Tetramad/magnetometer/Docs/schematic-magnetometer-v1.4.pdf

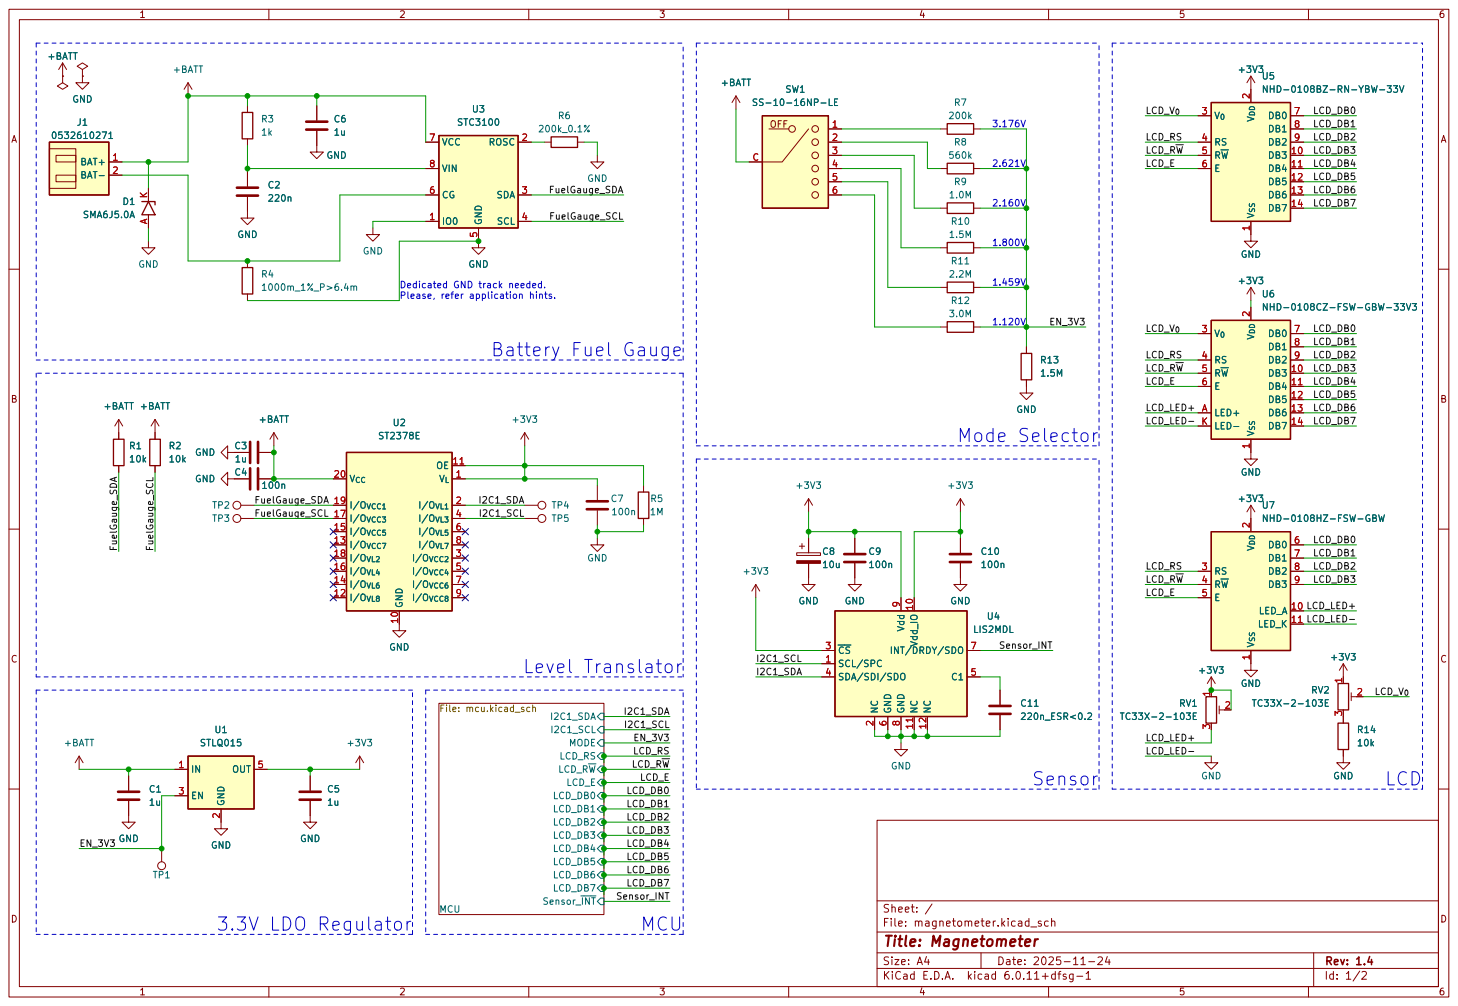
[picture p8: page 1]

3 U5 NHD-0108BZ-RN-YBW-33V V_{SS} 1 DB3

3 GND
+3V3 GND
U7 NHD-0108HZ-FSW-GBW V_{SS} 1

2 ~{CS} 3 SDA/SDI/SDO 4 C1 5 GND

6 INT/DRDY/SDO 7 GND

Id: 1/2 Title: Magnetometer File: magnetometer.kicad_sch Sheet: /

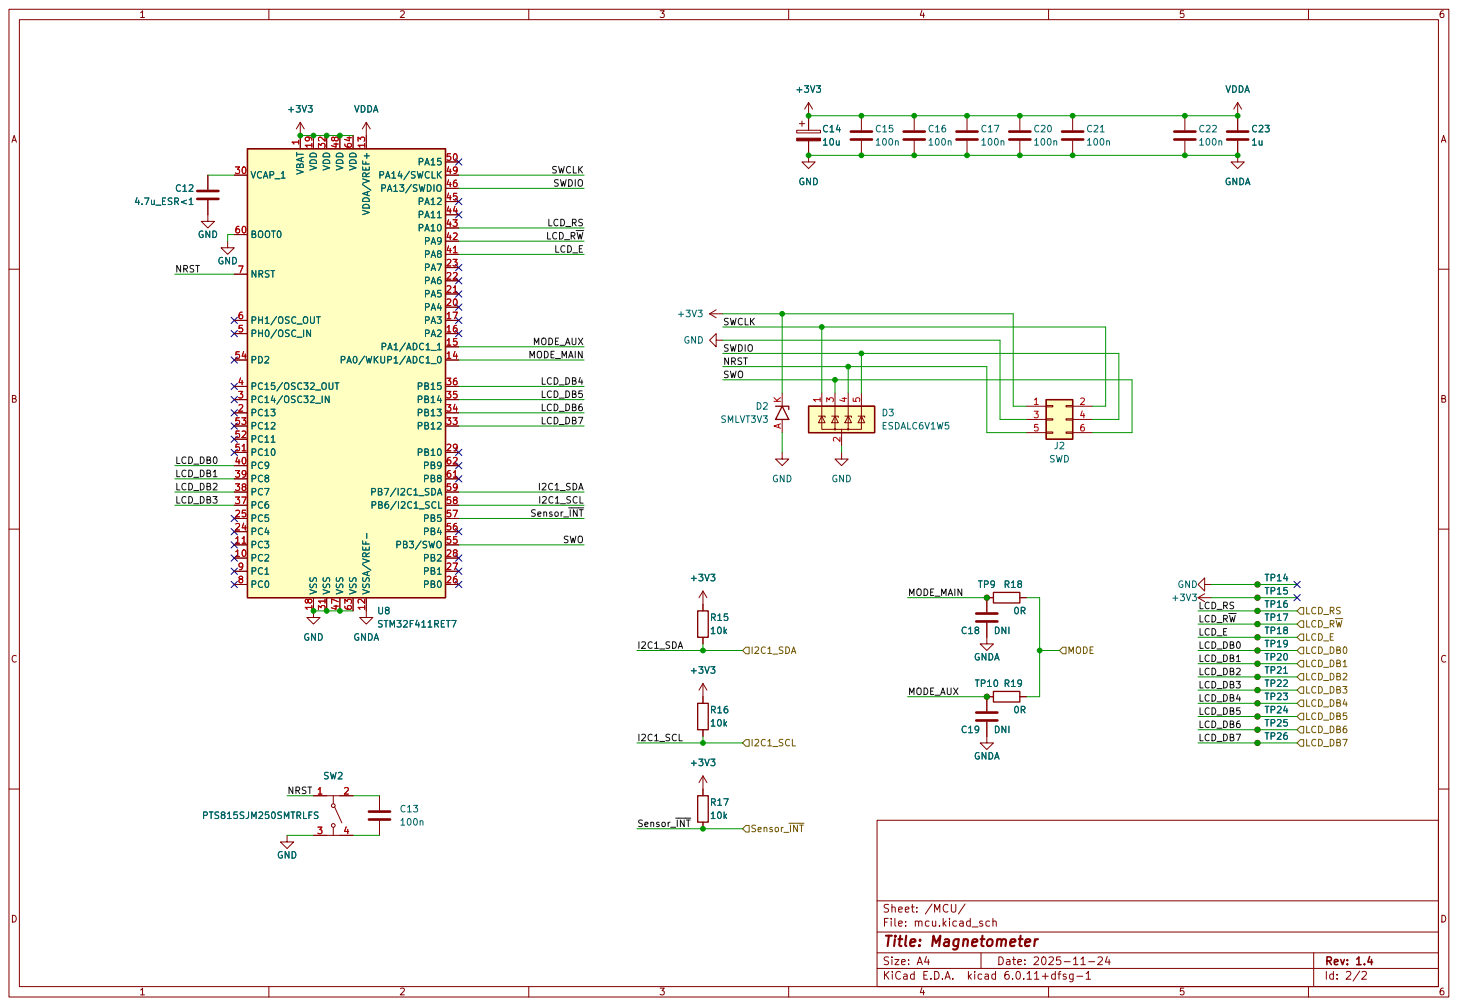
[picture p9: page 2]
