Tetramad/magnetometer/Docs/schematic-magnetometer-v1.1.pdf

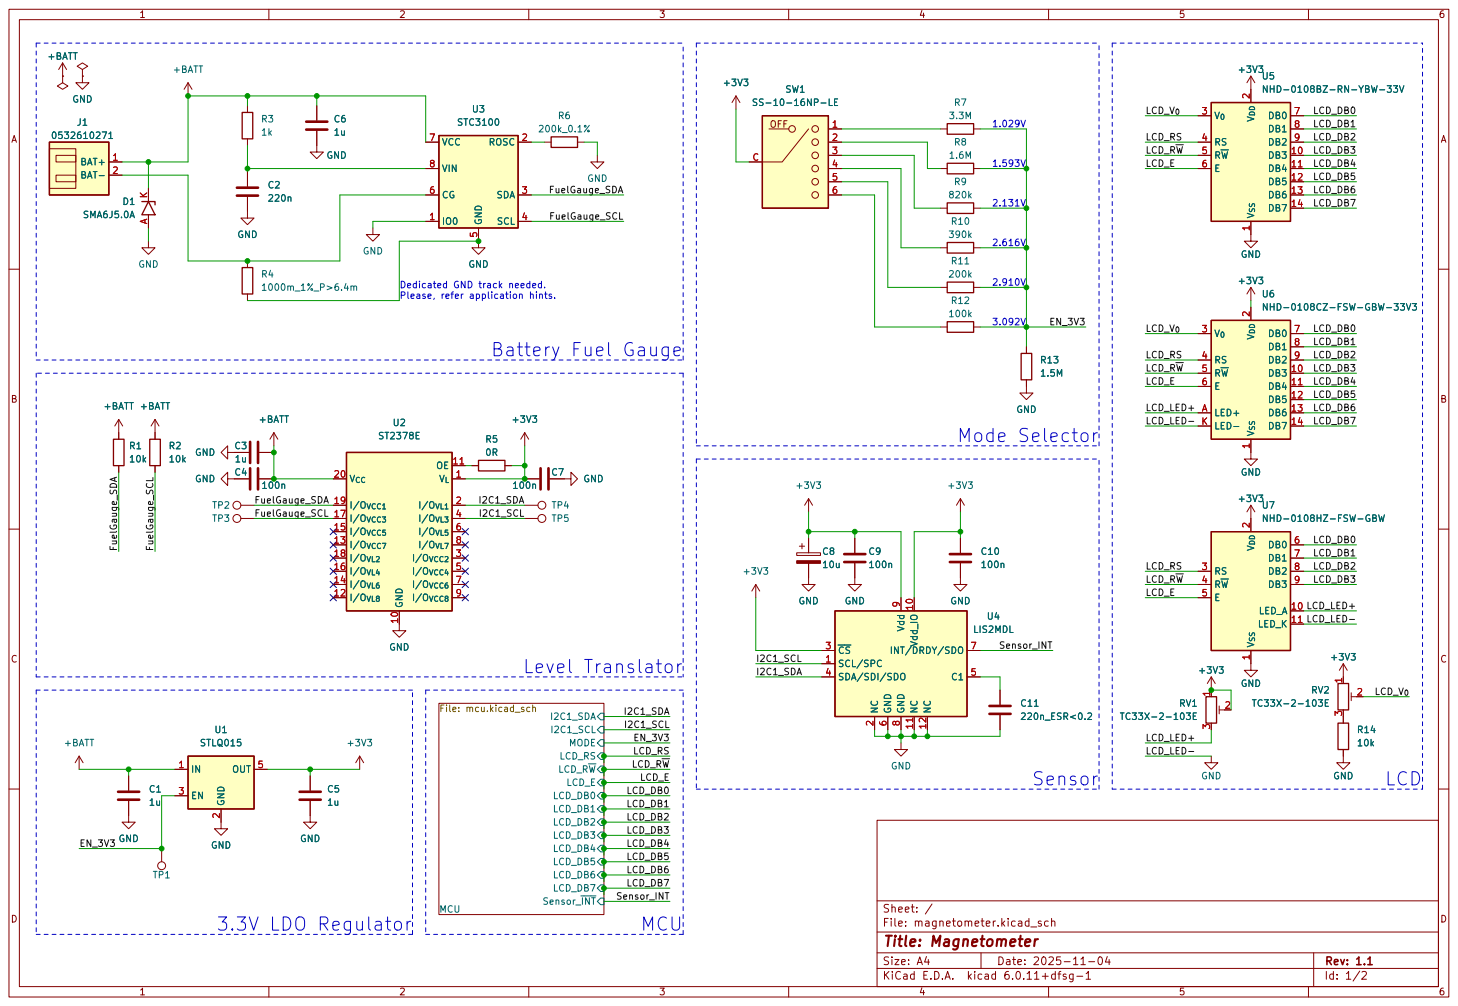
[picture p10: page 1]

U7 NHD-0108HZ-FSW-GBW V_{SS} 1

2 ~{CS} 3 SDA/SDI/SDO 4 C1 5 GND

6 INT/DRDY/SDO 7 GND

Id: 1/2 Title: Magnetometer File: magnetometer.kicad_sch Sheet: /

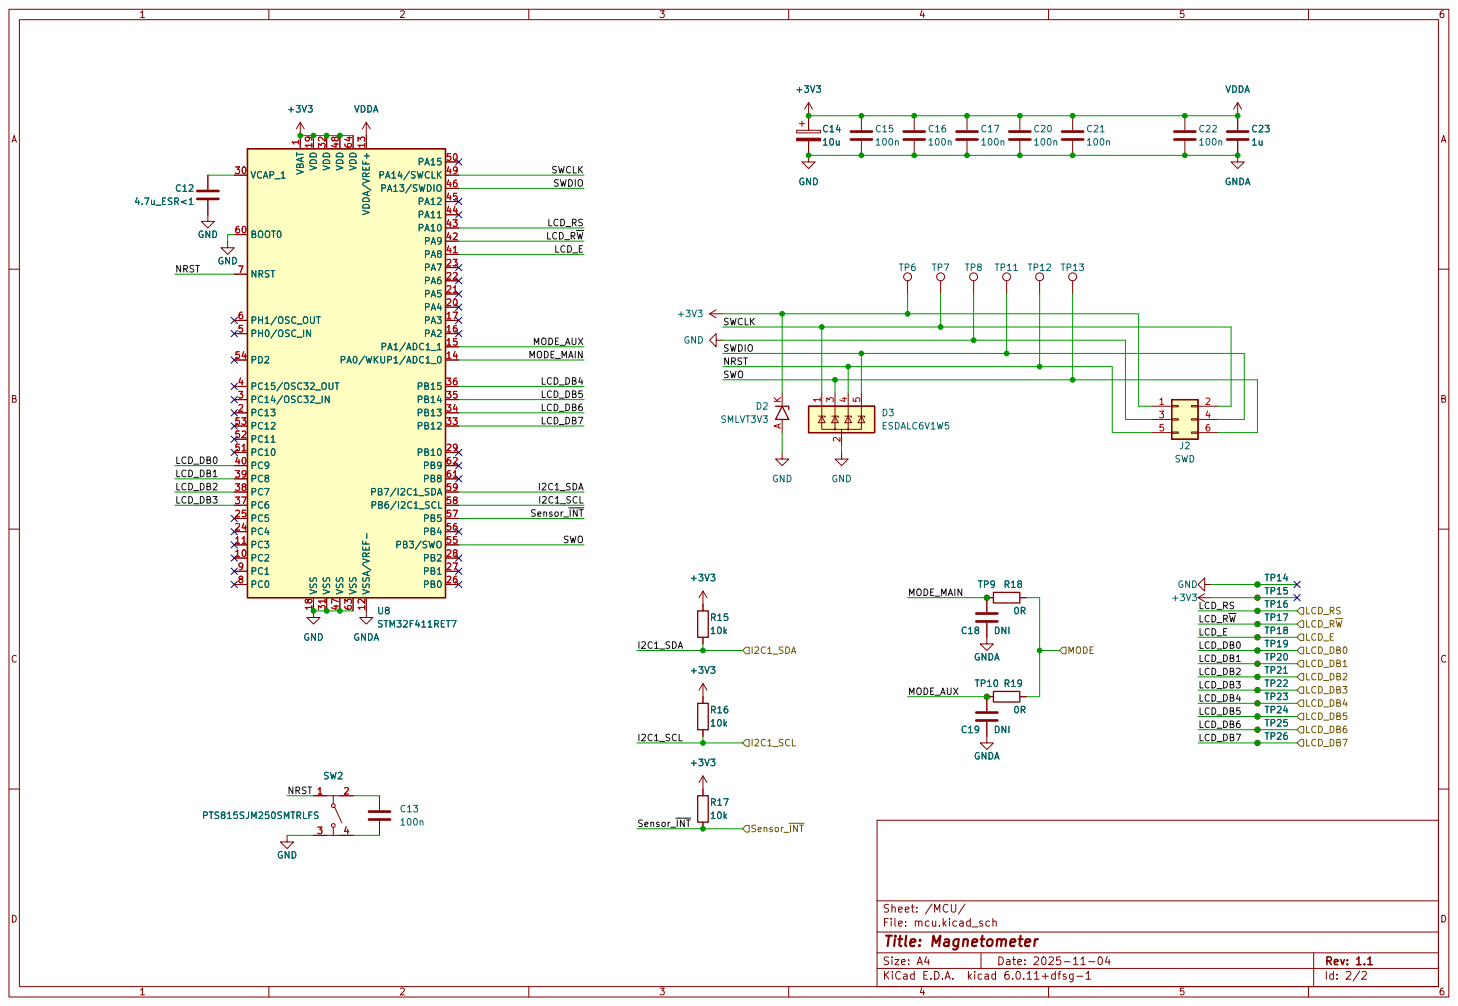
[picture p11: page 2]

Id: 2/2 Title: Magnetometer File: mcu.kicad_sch Sheet: /MCU/
