Tetramad/magnetometer/Core/Src/main.c

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
/* Includes ------------------------------------------------------------------*/
#include "main.h"

/* USER CODE BEGIN Includes */
#include <assert.h>
#include <math.h>
#include <stddef.h>
#include <stdint.h>
#include <stdlib.h>

#include <log.h>

/* USER CODE END Includes */

/* USER CODE BEGIN PTD */
struct tick_aligned_task {
    uint64_t target_tick;
    const uint16_t tick_alignment; /*< 32767 (~32s) Max. */
    HAL_StatusTypeDef (*const task)(void);
    const char *const name;
};

/* USER CODE END PTD */

/* USER CODE BEGIN PD */
#define MAGNETIC_FLUX_OFFSET_X ((int16_t)(151.319))
#define MAGNETIC_FLUX_OFFSET_Y ((int16_t)(304.571))
#define MAGNETIC_FLUX_OFFSET_Z ((int16_t)(-471.442))
/* USER CODE END PD */

ADC_HandleTypeDef hadc1;

I2C_HandleTypeDef hi2c1;

RTC_HandleTypeDef hrtc;

TIM_HandleTypeDef htim2;

/* USER CODE BEGIN PV */
LOG_LEVEL_SET(LOG_LEVEL_INF);

MOD_HandleTypeDef hmod;
LIS2MDL_HandleTypeDef hlis2mdl;
STC3100_HandleTypeDef hstc3100;
UDELAY_HandleTypeDef hmicrowait;
ST7066U_HandleTypeDef hdisplay;

MOD_ModeStateTypedef mode_state = MOD_MODE_STATE_UNKNOWN;

float magnetic_flux_x_mgauss = 0.0f;
float magnetic_flux_y_mgauss = 0.0f;
float magnetic_flux_z_mgauss = 0.0f;
float magnetic_flux_magnitude_mgauss = 0.0f;
float magnetic_flux_bearing_degree = 0.0f;

float gas_gauge_charge_used_uah = 0.0f;
float gas_gauge_voltage_mv = 0.0f;
/* USER CODE END PV */

void SystemClock_Config(void);
static void MX_GPIO_Init(void);
static void MX_ADC1_Init(void);
static void MX_I2C1_Init(void);
static void MX_RTC_Init(void);
static void MX_TIM2_Init(void);
/* USER CODE BEGIN PFP */
static void NotMX_MOD_Init(void);
static void NotMX_LIS2MDL_Init(void);
static void NotMX_STC3100_Init(void);
static void NotMX_UDELAY_Init(void);
static void NotMX_DISPLAY_Init(void);
static HAL_StatusTypeDef Task_ModeUpdate(void);
static HAL_StatusTypeDef Task_MagneticMeasurementUpdate(void);
static HAL_StatusTypeDef Task_SOHUpdate(void);
static HAL_StatusTypeDef Task_DisplayUpdate(void);
/* USER CODE END PFP */

/**
  * @brief  The application entry point.
  * @retval int
  */
int main(void) {

    /* USER CODE BEGIN 1 */
    HAL_StatusTypeDef status = HAL_OK;
    uint64_t latest_extend_tick = 0U;
    /* USER CODE END 1 */

    /* MCU Configuration--------------------------------------------------------*/

    /* Reset of all peripherals, Initializes the Flash interface and the Systick. */
    HAL_Init();

    /* Configure the system clock */
    SystemClock_Config();

    /* USER CODE BEGIN SysInit */
    HAL_Delay(50);
    /* USER CODE END SysInit */

    /* Initialize all configured peripherals */
    MX_GPIO_Init();
    MX_ADC1_Init();
    MX_I2C1_Init();
    MX_RTC_Init();
    MX_TIM2_Init();
    /* USER CODE BEGIN 2 */
    HAL_Delay(50);

    NotMX_MOD_Init();
    NotMX_LIS2MDL_Init();
    NotMX_STC3100_Init();
    NotMX_UDELAY_Init();
    NotMX_DISPLAY_Init();

    HAL_Delay(50);

    LOG_INF("Magnetometer");
    LOG_INF("H/W Rev.2");
    LOG_INF("F/W Ver.1.3.0");

    HAL_Delay(50);

    struct tick_aligned_task tasks[] = {
        [0] = {.target_tick = 0,
               .tick_alignment = 1000,
               .task = Task_ModeUpdate,
               .name = "ModeUpdate"},
        [1] = {.target_tick = 0,
               .tick_alignment = 200,
               .task = Task_MagneticMeasurementUpdate,
               .name = "MagneticMeasurementUpdate"},
        [2] = {.target_tick = 0,
               .tick_alignment = 1000,
               .task = Task_SOHUpdate,
               .name = "SOHUpdate"},
        [3] = {.target_tick = 0,
               .tick_alignment = 200,
               .task = Task_DisplayUpdate,
               .name = "DisplayUpdate"},
    };
    /* USER CODE END 2 */

    /* Infinite loop */
    /* USER CODE BEGIN WHILE */
    assert(sizeof(tasks) / sizeof(*tasks) > 0);
    for (struct tick_aligned_task *t = &tasks[0];
         t < &tasks[sizeof(tasks) / sizeof(*tasks)];
         ++t) {
        assert(t->target_tick <= UINT32_MAX &&
               t->tick_alignment <= UINT16_MAX / 2);
    }
    while (1) {
        const uint32_t current_tick = HAL_GetTick();
        if ((latest_extend_tick & 0xFFFFFFFFULL) > current_tick) {
            latest_extend_tick += 0x100000000ULL;
        }
        latest_extend_tick &= ~0xFFFFFFFFULL;
        latest_extend_tick += current_tick;

        struct tick_aligned_task *task = NULL;
        for (struct tick_aligned_task *t = &tasks[0];
             t < &tasks[sizeof(tasks) / sizeof(*tasks)];
             ++t) {
            if (t->target_tick <= latest_extend_tick) {
                task = t;
                break;
            }
        }

        if (task != NULL) {
            task->target_tick = latest_extend_tick -
                                (latest_extend_tick % task->tick_alignment) +
                                task->tick_alignment;
            if (task->task != NULL) {
                status = task->task();
                if (status != HAL_OK) {
                    LOG_ERR("task(%s) failed", task->name);
                    task->target_tick = UINT32_MAX;
                }
            }
            continue;
        }

        task = &tasks[0];
        for (struct tick_aligned_task *t = &tasks[0];
             t < &tasks[sizeof(tasks) / sizeof(*tasks)];
             ++t) {
            if (task->target_tick > t->target_tick) {
                task = t;
            }
        }

        assert(task->target_tick - latest_extend_tick <= UINT16_MAX / 2);
        const uint32_t stop_duration =
            (uint16_t)((task->target_tick - latest_extend_tick) * 2);
        HAL_SuspendTick();
        HAL_RTCEx_SetWakeUpTimer_IT(
            &hrtc, stop_duration, RTC_WAKEUPCLOCK_RTCCLK_DIV16);
        HAL_PWR_EnterSTOPMode(PWR_LOWPOWERREGULATOR_ON, PWR_STOPENTRY_WFI);
        HAL_RTCEx_DeactivateWakeUpTimer(&hrtc);
        /* Add elapsed tick while STOP */
        uwTick += (uint32_t)(task->target_tick - latest_extend_tick);
        HAL_ResumeTick();
        /* USER CODE END WHILE */

        /* USER CODE BEGIN 3 */
    }
    /* USER CODE END 3 */
}

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
/* USER CODE BEGIN 4 */
static void NotMX_MOD_Init(void) {
    hmod.ADCInstance = &hadc1;

    if (MOD_Init(&hmod) != HAL_OK) {
        Error_Handler();
    }
}

static void NotMX_LIS2MDL_Init(void) {
    hlis2mdl.I2CInstance = &hi2c1;

    if (LIS2MDL_Init(&hlis2mdl) != HAL_OK) {
        LOG_ERR("failed to initialize LIS2MDL");
        Error_Handler();
    }
}

static void NotMX_STC3100_Init(void) {
    hstc3100.I2CInstance = &hi2c1;

    if (STC3100_Init(&hstc3100) != HAL_OK) {
        LOG_ERR("failed to initialize STC3100");
        Error_Handler();
    }
}

static void NotMX_UDELAY_Init(void) {
    hmicrowait.TIMInstance = &htim2;

    if (UDELAY_Init(&hmicrowait) != HAL_OK) {
        LOG_ERR("failed to initialize MICROWAIT");
        Error_Handler();
    }
}

static void NotMX_DISPLAY_Init(void) {
    hdisplay.MICROWAITInstance = &hmicrowait;
    hdisplay.Init.BusMode = ST7066U_BUS_MODE_4;

    hdisplay.Init.RS_Port = LCD_RS_GPIO_Port;
    hdisplay.Init.RS_Pin = LCD_RS_Pin;
    hdisplay.Init.RW_Port = LCD_RW_GPIO_Port;
    hdisplay.Init.RW_Pin = LCD_RW_Pin;
    hdisplay.Init.E_Port = LCD_E_GPIO_Port;
    hdisplay.Init.E_Pin = LCD_E_Pin;

    hdisplay.Init.DB_Port[0] = LCD_DB0_GPIO_Port;
    hdisplay.Init.DB_Pin[0] = LCD_DB0_Pin;
    hdisplay.Init.DB_Port[1] = LCD_DB1_GPIO_Port;
    hdisplay.Init.DB_Pin[1] = LCD_DB1_Pin;
    hdisplay.Init.DB_Port[2] = LCD_DB2_GPIO_Port;
    hdisplay.Init.DB_Pin[2] = LCD_DB2_Pin;
    hdisplay.Init.DB_Port[3] = LCD_DB3_GPIO_Port;
    hdisplay.Init.DB_Pin[3] = LCD_DB3_Pin;
    hdisplay.Init.DB_Port[4] = LCD_DB4_GPIO_Port;
    hdisplay.Init.DB_Pin[4] = LCD_DB4_Pin;
    hdisplay.Init.DB_Port[5] = LCD_DB5_GPIO_Port;
    hdisplay.Init.DB_Pin[5] = LCD_DB5_Pin;
    hdisplay.Init.DB_Port[6] = LCD_DB6_GPIO_Port;
    hdisplay.Init.DB_Pin[6] = LCD_DB6_Pin;
    hdisplay.Init.DB_Port[7] = LCD_DB7_GPIO_Port;
    hdisplay.Init.DB_Pin[7] = LCD_DB7_Pin;

    if (ST7066U_Init(&hdisplay) != HAL_OK) {
        LOG_ERR("failed to initialize DISPLAY");
        Error_Handler();
    }
}

HAL_StatusTypeDef Task_ModeUpdate(void) {
    HAL_StatusTypeDef status = HAL_OK;

    status = MOD_UpdateMode(&hmod);
    if (status != HAL_OK) {
        LOG_ERR("failed to update mode");
        return HAL_ERROR;
    }

    mode_state = MOD_ReadMode(&hmod);

    switch (mode_state) {
    default:
    case MOD_MODE_STATE_UNKNOWN:
        LOG_DBG("Mode [Unknown]");
        return HAL_OK;
    case MOD_MODE_STATE_X:
        LOG_DBG("Mode [X]");
        return HAL_OK;
    case MOD_MODE_STATE_Y:
        LOG_DBG("Mode [Y]");
        return HAL_OK;
    case MOD_MODE_STATE_Z:
        LOG_DBG("Mode [Z]");
        return HAL_OK;
    case MOD_MODE_STATE_MAGNITUDE:
        LOG_DBG("Mode [Magnitude]");
        return HAL_OK;
    case MOD_MODE_STATE_BEARING:
        LOG_DBG("Mode [Bearing]");
        return HAL_OK;
    case MOD_MODE_STATE_SOH:
        LOG_DBG("Mode [SOH]");
        return HAL_OK;
    }
}

HAL_StatusTypeDef Task_MagneticMeasurementUpdate(void) {
    HAL_StatusTypeDef status = HAL_OK;

    status = LIS2MDL_CheckSanity(&hlis2mdl);
    if (status != HAL_OK) {
        return HAL_ERROR;
    }

    status = LIS2MDL_StartSingleMode(&hlis2mdl);
    if (status != HAL_OK) {
        return HAL_ERROR;
    }

    uint16_t x_code = 0U;
    uint16_t y_code = 0U;
    uint16_t z_code = 0U;

    status = LIS2MDL_OUTXYZ(&hlis2mdl, &x_code, &y_code, &z_code);
    if (status != HAL_OK) {
        return HAL_ERROR;
    }

    const float x_mgauss =
        (float)((int16_t)x_code - MAGNETIC_FLUX_OFFSET_X) * 1.5f;
    const float y_mgauss =
        (float)((int16_t)y_code - MAGNETIC_FLUX_OFFSET_Y) * 1.5f;
    const float z_mgauss =
        (float)((int16_t)z_code - MAGNETIC_FLUX_OFFSET_Z) * 1.5f;

    float magnitude_mgauss = 0.0f;
    {
        float acc = 0.0f;

        acc += x_mgauss * x_mgauss;
        acc += y_mgauss * y_mgauss;
        acc += z_mgauss * z_mgauss;

        magnitude_mgauss = sqrtf(acc);
    }

    float bearing_degree = 0.0f;
    {
        float theta = 0.0f;

        if (isless(fabsf(x_mgauss), 0.001f) &&
            isless(fabsf(y_mgauss), 0.001f)) {
            theta = 0.0f;
        } else if (isless(fabsf(x_mgauss), 0.001f) && signbit(y_mgauss)) {
            theta = (float)M_PI_2 * 3.0f;
        } else if (isless(fabsf(x_mgauss), 0.001f) && !signbit(y_mgauss)) {
            theta = (float)M_PI_2 * 1.0f;
        } else {
            theta =
                atanf(y_mgauss / -x_mgauss) +
                (!signbit(x_mgauss) * (float)M_PI) +
                ((signbit(x_mgauss) && signbit(y_mgauss)) * 2.0f * (float)M_PI);
        }

        bearing_degree = theta * 180.0f / (float)M_PI;
    };

    magnetic_flux_x_mgauss = x_mgauss;
    magnetic_flux_y_mgauss = y_mgauss;
    magnetic_flux_z_mgauss = z_mgauss;
    magnetic_flux_magnitude_mgauss = magnitude_mgauss;
    magnetic_flux_bearing_degree = bearing_degree;

    return HAL_OK;
}

static HAL_StatusTypeDef Task_SOHUpdate(void) {
    HAL_StatusTypeDef status = HAL_OK;

    status = STC3100_CheckSanity(&hstc3100);
    if (status != HAL_OK) {
        return HAL_ERROR;
    }

    gas_gauge_charge_used_uah = STC3100_ChargeUsed_uAh(&hstc3100);

    LOG_DBG("Charge Used: %d uAh", (int)gas_gauge_charge_used_uah);

    return HAL_OK;
}

static HAL_StatusTypeDef Task_DisplayUpdate(void) {
    assert(abs((int)magnetic_flux_x_mgauss) <= 99999);
    assert(abs((int)magnetic_flux_y_mgauss) <= 99999);
    assert(abs((int)magnetic_flux_z_mgauss) <= 99999);
    assert(abs((int)magnetic_flux_magnitude_mgauss) <= 99999);

    if (ST7066U_CheckSanity(&hdisplay) != HAL_OK) {
        return HAL_ERROR;
    }

    switch (mode_state) {
    default:
    case MOD_MODE_STATE_UNKNOWN:
        return ST7066U_Print(&hdisplay, "%s", "Unknown");
    case MOD_MODE_STATE_X:
        return ST7066U_Print(&hdisplay, "X %6d", (int)magnetic_flux_x_mgauss);
    case MOD_MODE_STATE_Y:
        return ST7066U_Print(&hdisplay, "Y %6d", (int)magnetic_flux_y_mgauss);
    case MOD_MODE_STATE_Z:
        return ST7066U_Print(&hdisplay, "Z %6d", (int)magnetic_flux_z_mgauss);
    case MOD_MODE_STATE_MAGNITUDE:
        return ST7066U_Print(
            &hdisplay, "M %6d", (int)magnetic_flux_magnitude_mgauss);
    case MOD_MODE_STATE_BEARING:
        return ST7066U_Print(
            &hdisplay, "B %6d", (int)magnetic_flux_bearing_degree);
    case MOD_MODE_STATE_SOH:
        if (gas_gauge_charge_used_uah < 1000.0f) {
            return ST7066U_Print(
                &hdisplay, "S %5du", (int)gas_gauge_charge_used_uah);
        } else {
            return ST7066U_Print(&hdisplay,
                                 "S %5dm",
                                 (int)(gas_gauge_charge_used_uah / 1000.0f));
        }
    }
}
/* USER CODE END 4 */
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
