Tetramad/magnetometer/(commit log)

2025-09-22 feat: PoC board bringed-up
2025-09-28 feat: move to STM32CubeIDE
2025-09-30 fix: fix non-incremental reading of I2C and tidy out some identifiers
    [lis2mdl.c, lis2mdl_reg.h, main.c]
2025-11-27 feat: change to the new Rev.1.1 board
2025-12-01 fix: wrong range for Bearing and SOH ADC codes
    [mode_selector.c]
2025-12-02 feat: big update for mostly I2C things
    - change LIS2MDL driver code for bettery
    - Implements STC3100 Gas Gauge(Column Counter) driver
2025-12-04 fix: change to do not reinit the LIS2MDL when failed
    [main.c]
2025-12-04 feat: introduce micro wait timer
2025-12-05 feat: implement display driver
2025-12-06 feat: measure and apply sensor offset
2025-12-06 fix: fix wrong bearing reading
    [main.c]
2025-12-06 chore: remote unused voltage readings
2025-12-06 fix: change wrong startup gpio configs and chores
    [display.h, main.c]
2025-12-06 chore: restore I2C speed to 100kHz
2025-12-07 feat: change ambiguous name "display" to proper driver ST7066U
2025-12-07 feat: enter standby mode when peripheral initialize failed
    [main.c]
